joaopedroquintino/MQTT-Glove-Robotic_Arm-ESP32/Software PC/Object_3D/src/object_3d/Object.java

package object_3d;

import com.sun.j3d.utils.universe.SimpleUniverse;
import com.sun.j3d.utils.geometry.Box;
import javax.media.j3d.BranchGroup;
import javax.media.j3d.Transform3D;
import javax.media.j3d.TransformGroup;
import javax.media.j3d.Canvas3D;
import javax.swing.JFrame;
import java.awt.BorderLayout;
import java.awt.Color;
import java.awt.GraphicsConfiguration;
import javax.media.j3d.Alpha;
import javax.media.j3d.Appearance;
import javax.media.j3d.BoundingSphere;
import javax.media.j3d.ColoringAttributes;
import javax.media.j3d.PolygonAttributes;
import javax.media.j3d.RotationInterpolator;
import object_3d.jPanel1;

public class Object extends JFrame {
    private Transform3D rotate1 = new Transform3D();
    private Transform3D rotate2 = new Transform3D();
    public Object() {
        super("Object");
        initComponents();
        Canvas3D canvas3D = createCanvas3D();
        BranchGroup scene = createSceneGraph();
        canvas1 = canvas3D;
        connect(canvas3D, scene);
        
    }
    /**
     * This method is called from within the constructor to initialize the form.
     * WARNING: Do NOT modify this code. The content of this method is always
     * regenerated by the Form Editor.
     */
    private Canvas3D createCanvas3D() {
        jInternalFrame1.setSize(300, 300);
        setLayout(new BorderLayout());
        GraphicsConfiguration config
                = SimpleUniverse.getPreferredConfiguration();
        Canvas3D canvas3D = new Canvas3D(config);
        jInternalFrame1.setSize(300, 300);
        jInternalFrame1.getContentPane().add(canvas3D);
        return canvas3D;
    }

    private BranchGroup createSceneGraph() {
        BranchGroup objRoot = new BranchGroup();
        //TransformGroup rotator = new TransformGroup(rotateCube());
        //objRoot.addChild(rotator);
        Appearance appearance = new Appearance();
        appearance.setColoringAttributes(new ColoringAttributes(0.2f, 0.2f, 0.4f, 1));
        PolygonAttributes pa = new PolygonAttributes();
        pa.setPolygonMode(2);
        appearance.setPolygonAttributes(pa);
        //rotator.addChild(new Box(0.3f,0.1f,0.3f, appearance));
        TransformGroup spinner = new TransformGroup();
        spinner.setCapability(TransformGroup.ALLOW_TRANSFORM_WRITE);
        objRoot.addChild(spinner);
        spinner.addChild(new Box(0.3f, 0.1f, 0.3f, appearance));
        spinner.addChild(makeSpin(spinner));
        objRoot.compile();

        return objRoot;
    }

    private RotationInterpolator makeSpin(TransformGroup spinner) {
        RotationInterpolator rotator = 
                new RotationInterpolator(new Alpha(-1,3000), spinner);
        rotator.setAxisOfRotation(rotateCube());
        BoundingSphere bounds = new BoundingSphere();
        rotator.setSchedulingBounds(bounds);
        return rotator;
    }

    private Transform3D rotateCube() {
        rotate1.rotX(Math.PI /6.0d );
        rotate2.rotY(Math.PI /6.0d );
        rotate1.mul(rotate2);
        return rotate1;
    }

    public void connect(Canvas3D canvas3D, BranchGroup scene) {
        SimpleUniverse simpleU = new SimpleUniverse(canvas3D);
        simpleU.getViewingPlatform().setNominalViewingTransform();
        simpleU.addBranchGraph(scene);
    }
    
    
    @SuppressWarnings("unchecked")
    // <editor-fold defaultstate="collapsed" desc="Generated Code">//GEN-BEGIN:initComponents
    private void initComponents() {

        button1 = new java.awt.Button();
        jInternalFrame1 = new javax.swing.JInternalFrame();
        canvas1 = createCanvas3D();

        setDefaultCloseOperation(javax.swing.WindowConstants.EXIT_ON_CLOSE);
        addWindowListener(new java.awt.event.WindowAdapter() {
            public void windowOpened(java.awt.event.WindowEvent evt) {
                formWindowOpened(evt);
            }
        });

        button1.setLabel("button1");

        jInternalFrame1.setVisible(true);

        javax.swing.GroupLayout jInternalFrame1Layout = new javax.swing.GroupLayout(jInternalFrame1.getContentPane());
        jInternalFrame1.getContentPane().setLayout(jInternalFrame1Layout);
        jInternalFrame1Layout.setHorizontalGroup(
            jInternalFrame1Layout.createParallelGroup(javax.swing.GroupLayout.Alignment.LEADING)
            .addGap(0, 304, Short.MAX_VALUE)
        );
        jInternalFrame1Layout.setVerticalGroup(
            jInternalFrame1Layout.createParallelGroup(javax.swing.GroupLayout.Alignment.LEADING)
            .addGap(0, 300, Short.MAX_VALUE)
        );

        javax.swing.GroupLayout layout = new javax.swing.GroupLayout(getContentPane());
        getContentPane().setLayout(layout);
        layout.setHorizontalGroup(
            layout.createParallelGroup(javax.swing.GroupLayout.Alignment.LEADING)
            .addGroup(javax.swing.GroupLayout.Alignment.TRAILING, layout.createSequentialGroup()
                .addGap(25, 25, 25)
                .addComponent(button1, javax.swing.GroupLayout.PREFERRED_SIZE, javax.swing.GroupLayout.DEFAULT_SIZE, javax.swing.GroupLayout.PREFERRED_SIZE)
                .addPreferredGap(javax.swing.LayoutStyle.ComponentPlacement.RELATED)
                .addComponent(canvas1, javax.swing.GroupLayout.PREFERRED_SIZE, 300, javax.swing.GroupLayout.PREFERRED_SIZE)
                .addPreferredGap(javax.swing.LayoutStyle.ComponentPlacement.RELATED)
                .addComponent(jInternalFrame1, javax.swing.GroupLayout.PREFERRED_SIZE, javax.swing.GroupLayout.DEFAULT_SIZE, javax.swing.GroupLayout.PREFERRED_SIZE)
                .addContainerGap(26, Short.MAX_VALUE))
        );
        layout.setVerticalGroup(
            layout.createParallelGroup(javax.swing.GroupLayout.Alignment.LEADING)
            .addGroup(javax.swing.GroupLayout.Alignment.TRAILING, layout.createSequentialGroup()
                .addContainerGap(77, Short.MAX_VALUE)
                .addGroup(layout.createParallelGroup(javax.swing.GroupLayout.Alignment.LEADING, false)
                    .addComponent(jInternalFrame1, javax.swing.GroupLayout.PREFERRED_SIZE, javax.swing.GroupLayout.DEFAULT_SIZE, javax.swing.GroupLayout.PREFERRED_SIZE)
                    .addGroup(layout.createSequentialGroup()
                        .addGap(150, 150, 150)
                        .addComponent(button1, javax.swing.GroupLayout.PREFERRED_SIZE, javax.swing.GroupLayout.DEFAULT_SIZE, javax.swing.GroupLayout.PREFERRED_SIZE))
                    .addGroup(javax.swing.GroupLayout.Alignment.TRAILING, layout.createSequentialGroup()
                        .addComponent(canvas1, javax.swing.GroupLayout.DEFAULT_SIZE, javax.swing.GroupLayout.DEFAULT_SIZE, Short.MAX_VALUE)
                        .addContainerGap())))
        );

        pack();
    }// </editor-fold>//GEN-END:initComponents

    private void formWindowOpened(java.awt.event.WindowEvent evt) {//GEN-FIRST:event_formWindowOpened
        
    }//GEN-LAST:event_formWindowOpened
    
    /**
     * @param args the command line arguments
     */
    public static void main(String args[]) {
        /* Set the Nimbus look and feel */
        //<editor-fold defaultstate="collapsed" desc=" Look and feel setting code (optional) ">
        /* If Nimbus (introduced in Java SE 6) is not available, stay with the default look and feel.
         * For details see http://download.oracle.com/javase/tutorial/uiswing/lookandfeel/plaf.html 
         */
        try {
            for (javax.swing.UIManager.LookAndFeelInfo info : javax.swing.UIManager.getInstalledLookAndFeels()) {
                if ("Nimbus".equals(info.getName())) {
                    javax.swing.UIManager.setLookAndFeel(info.getClassName());
                    break;
                }
            }
        } catch (ClassNotFoundException ex) {
            java.util.logging.Logger.getLogger(Object.class.getName()).log(java.util.logging.Level.SEVERE, null, ex);
        } catch (InstantiationException ex) {
            java.util.logging.Logger.getLogger(Object.class.getName()).log(java.util.logging.Level.SEVERE, null, ex);
        } catch (IllegalAccessException ex) {
            java.util.logging.Logger.getLogger(Object.class.getName()).log(java.util.logging.Level.SEVERE, null, ex);
        } catch (javax.swing.UnsupportedLookAndFeelException ex) {
            java.util.logging.Logger.getLogger(Object.class.getName()).log(java.util.logging.Level.SEVERE, null, ex);
        }
        //</editor-fold>

        /* Create and display the form */
        java.awt.EventQueue.invokeLater(new Runnable() {
            public void run() {
                new Object().setVisible(true);
            }
        });
    }
    
    

    // Variables declaration - do not modify//GEN-BEGIN:variables
    private java.awt.Button button1;
    private java.awt.Canvas canvas1;
    private javax.swing.JInternalFrame jInternalFrame1;
    // End of variables declaration//GEN-END:variables
}
